ryood/ACS712_AmMeter/IMG_20200204_164413.jpg

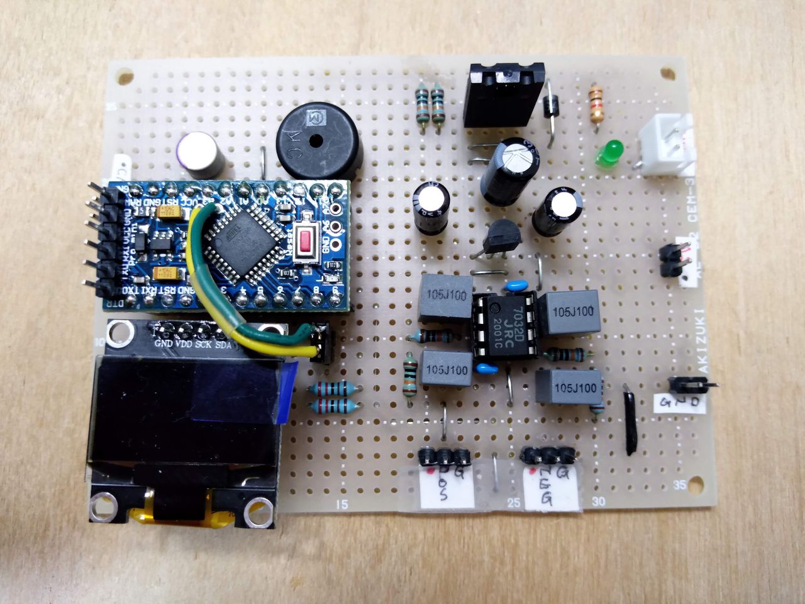
IMG_20200204_164413.jpg
