ryood/ACS712_AmMeter/IMG_20200204_164611.jpg

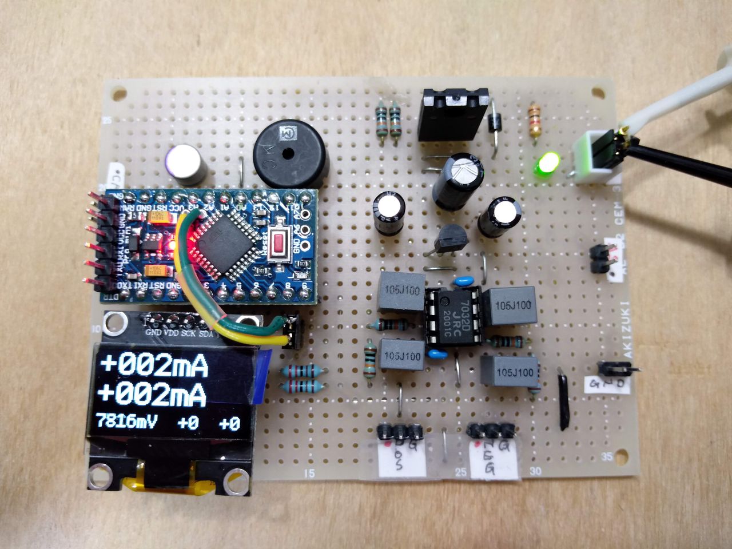
IMG_20200204_164611.jpg
