ryood/ACS712_AmMeter/ACS712-Dual.jpg

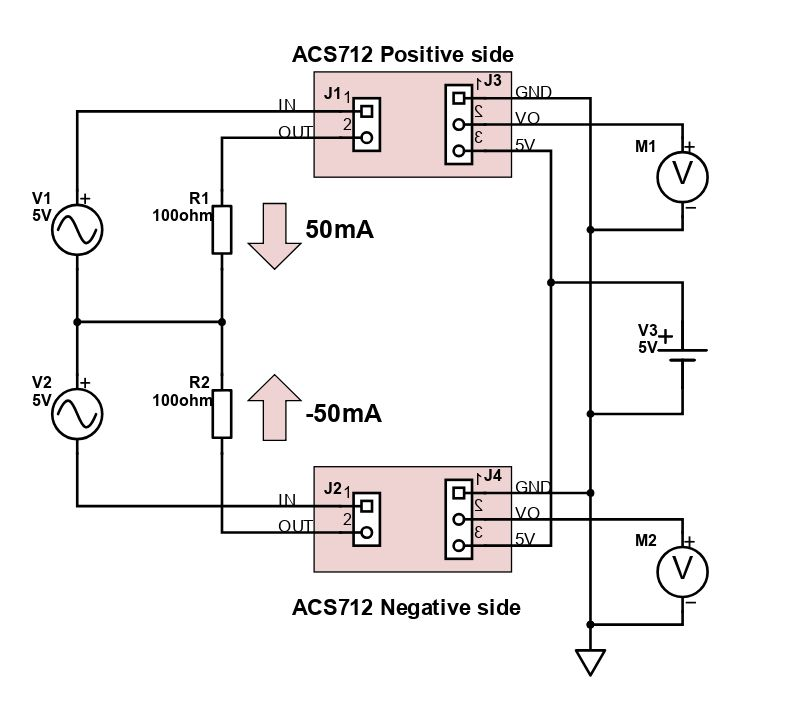
ACS712-Dual.jpg
