ryood/ACS712_AmMeter/ACS712_AmMeter_Diagram.png

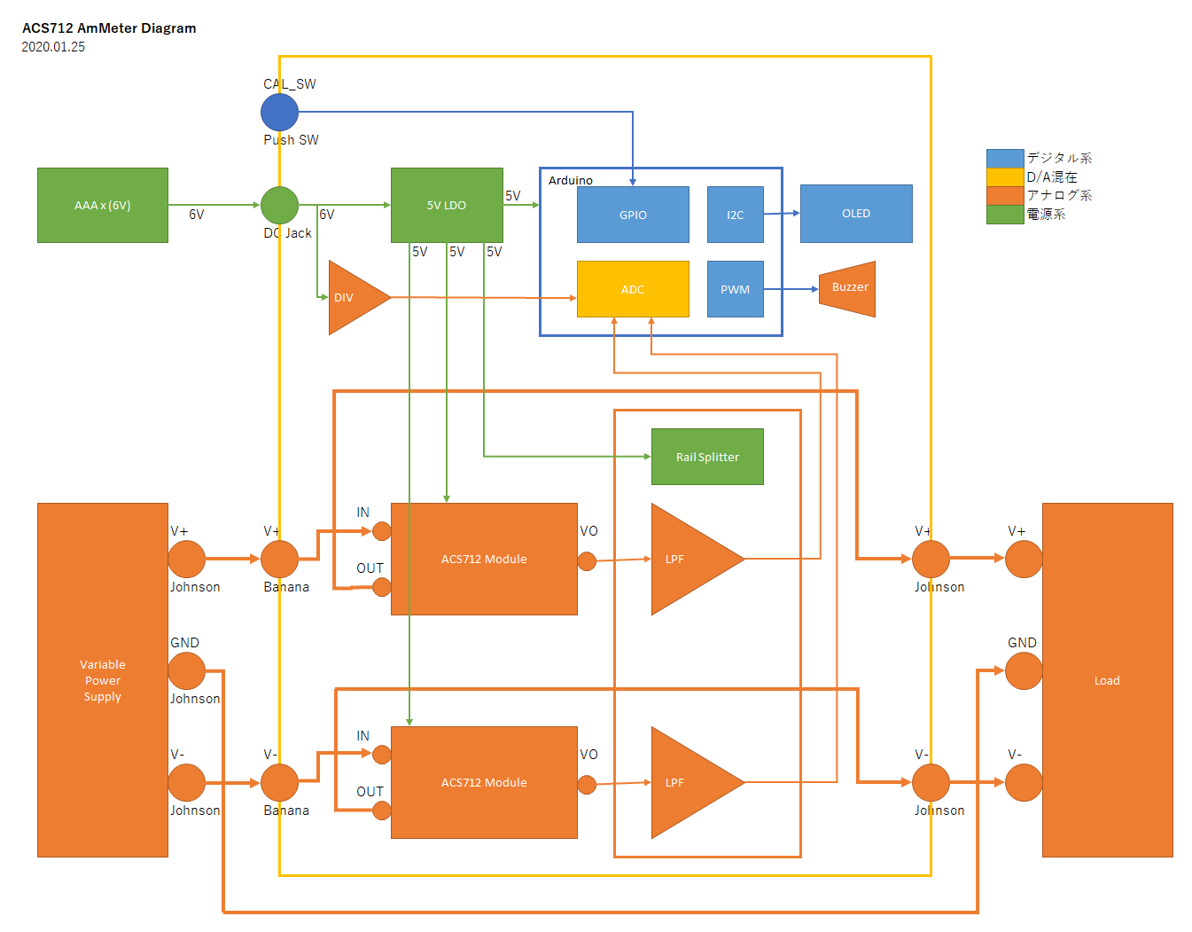
ACS712_AmMeter_Diagram.png
