ryood/ACS712_AmMeter/ACS712_AmMeter_Negative_Graph.png

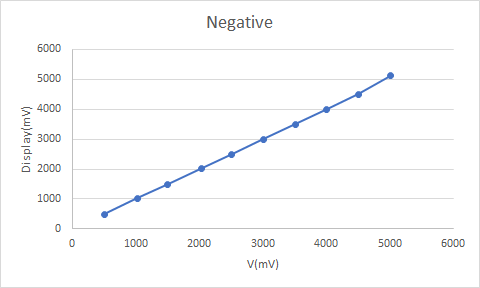
ACS712_AmMeter_Negative_Graph.png
