ryood/ACS712_AmMeter/etc/20200102_085544.png

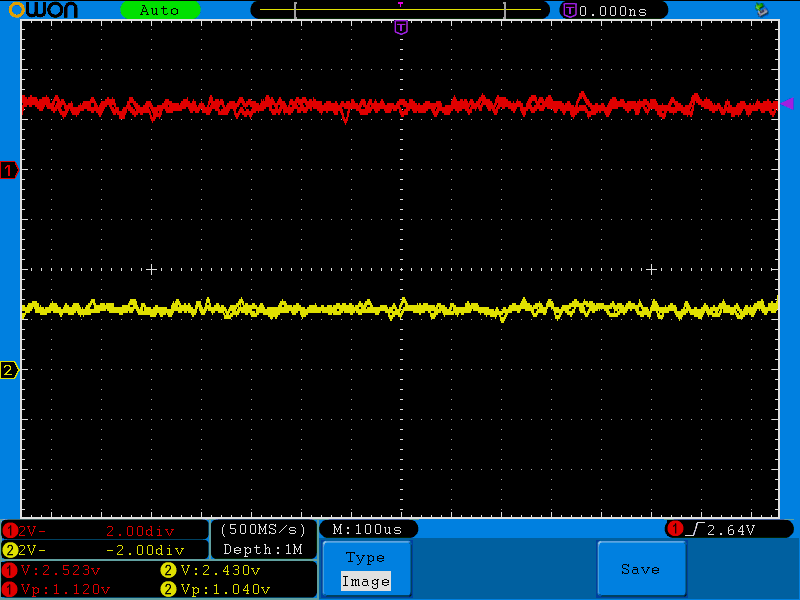
etc/20200102_085544.png
