ryood/ACS712_AmMeter/etc/20200102_085621.png

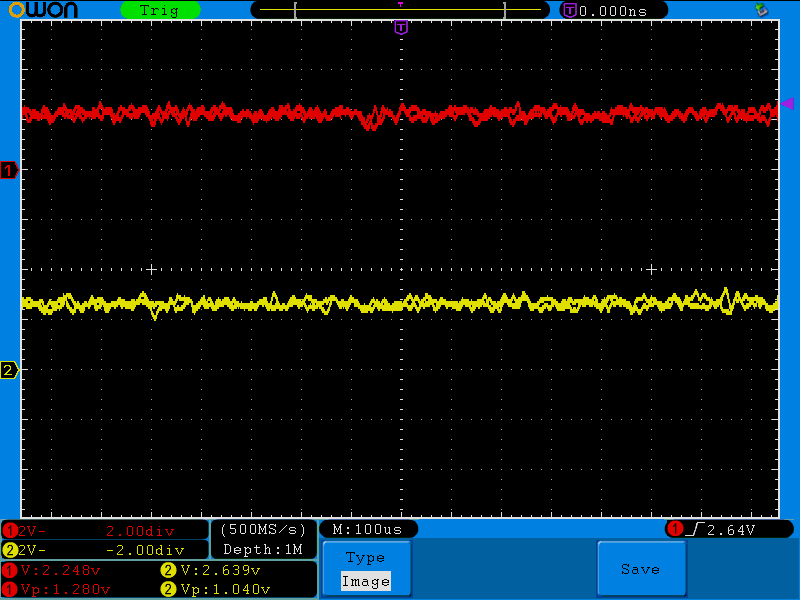
etc/20200102_085621.png
