ryood/ACS712_AmMeter/etc/20200102_085722.png

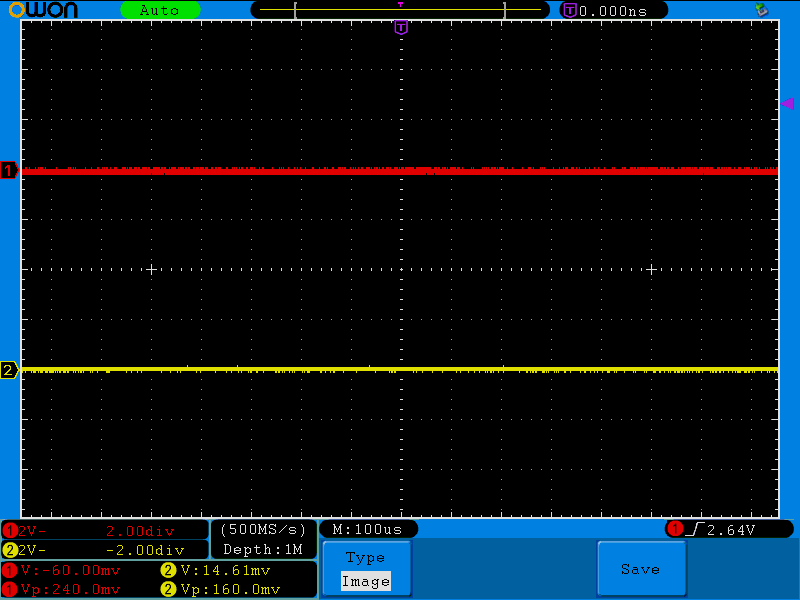
etc/20200102_085722.png
