ryood/ACS712_AmMeter/etc/IMG_20191228_145746.jpg

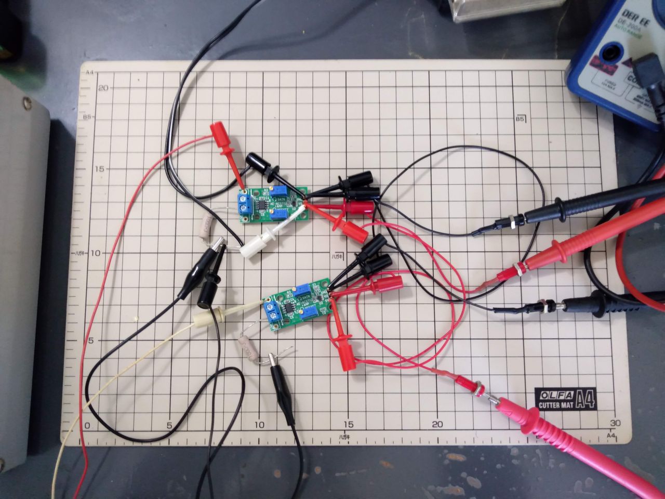
etc/IMG_20191228_145746.jpg
