ryood/ACS712_AmMeter/etc/IMG_20191228_152914.jpg

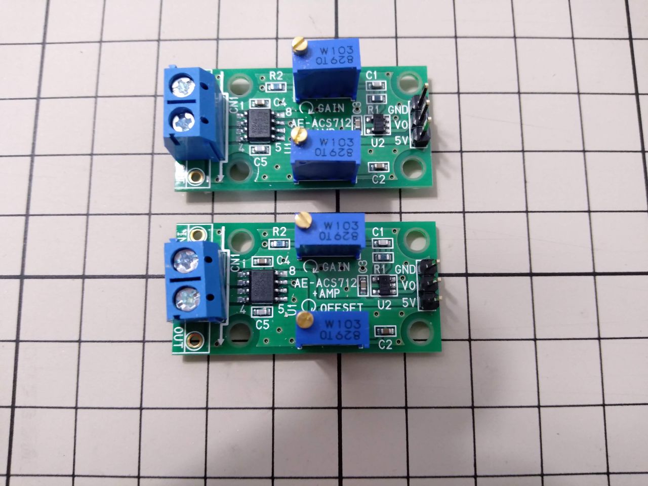
etc/IMG_20191228_152914.jpg
