ryood/ACS712_AmMeter/etc/IMG_20200102_083424.jpg

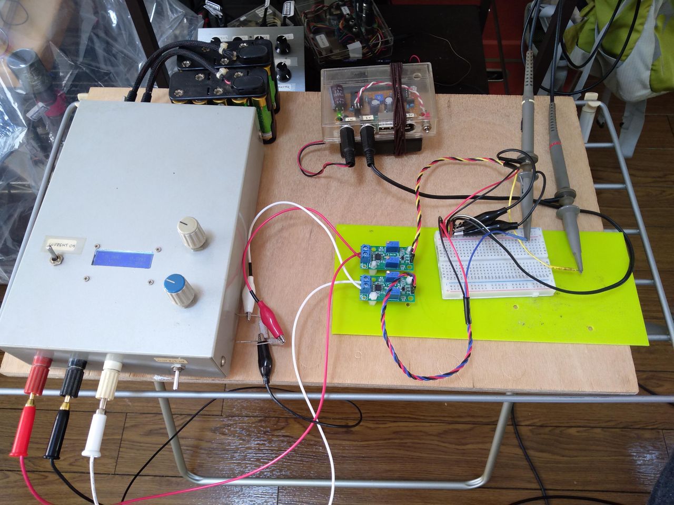
etc/IMG_20200102_083424.jpg
