ryood/ACS712_AmMeter/fritzing/ACS712_AmMeter_VCVS_LPF_ブレッドボード.png

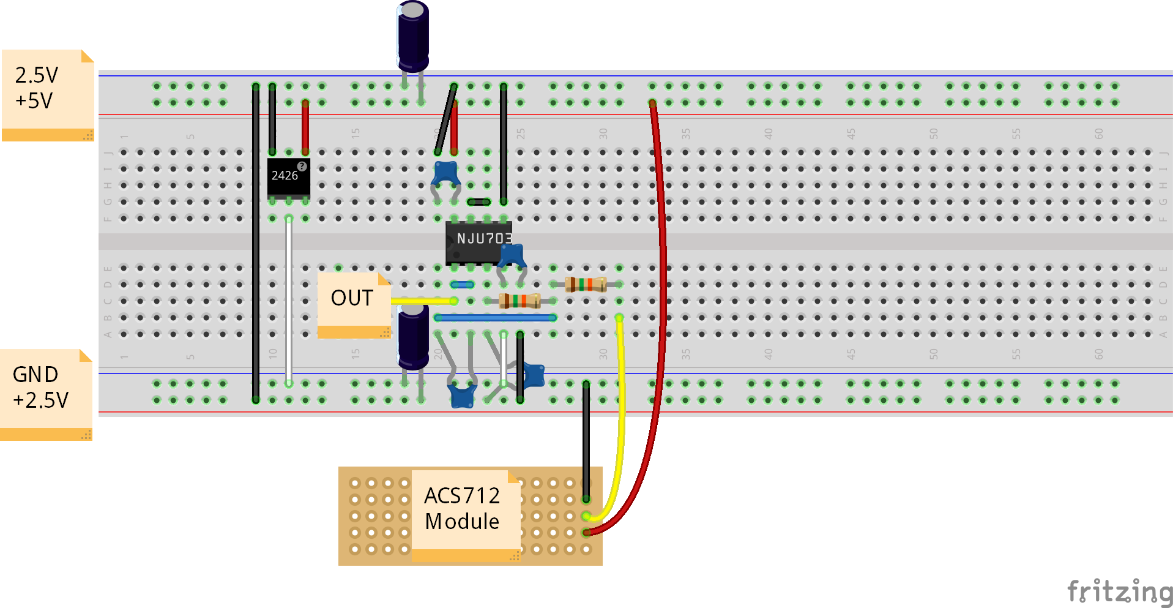
fritzing/ACS712_AmMeter_VCVS_LPF_ブレッドボード.png
