ryood/ACS712_AmMeter/IMG_20200204_164301.jpg

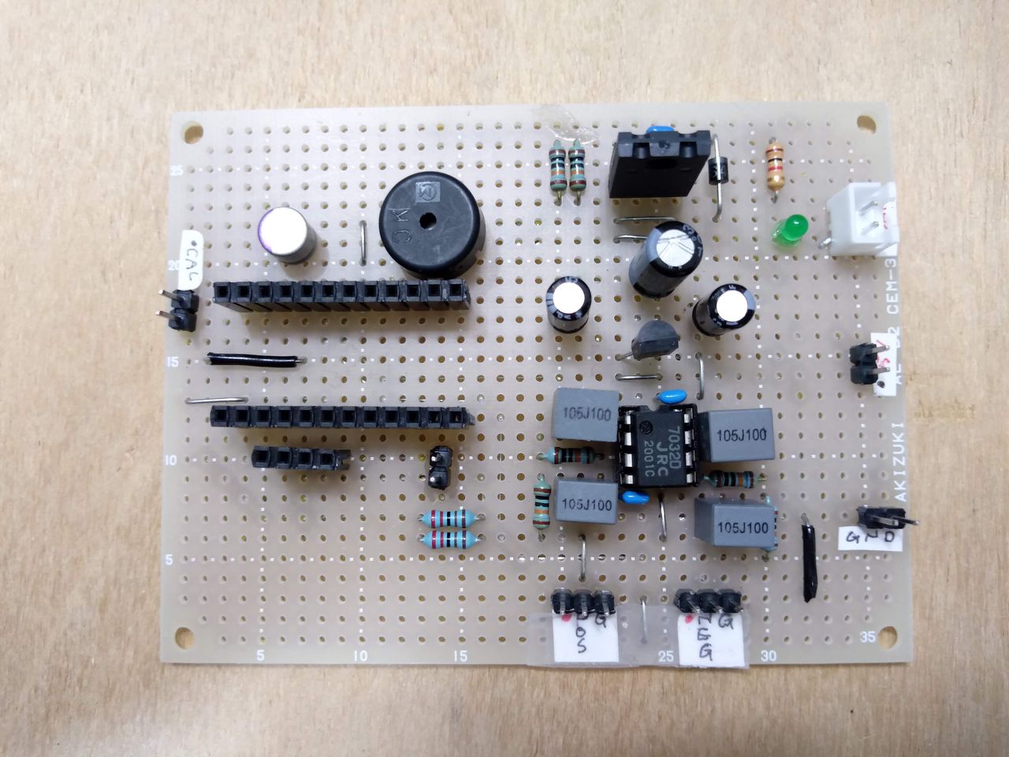
IMG_20200204_164301.jpg
