ryood/ACS712_AmMeter/IMG_20200204_164309.jpg

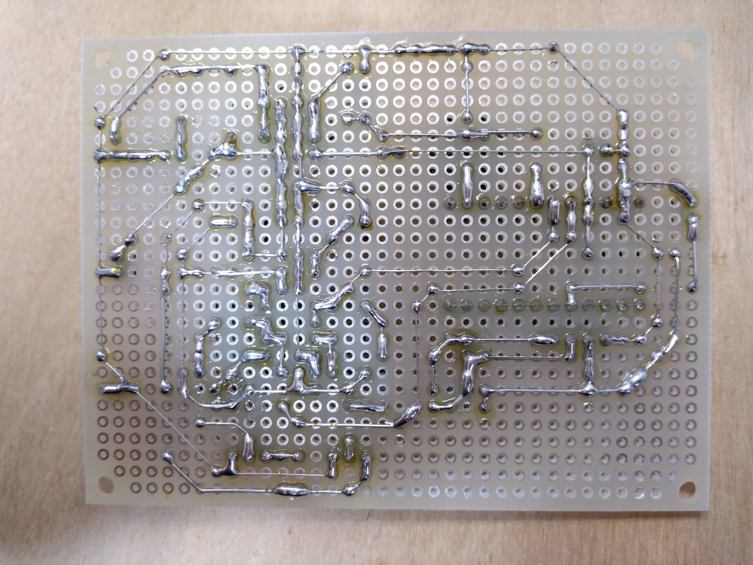
IMG_20200204_164309.jpg
