ryood/ACS712_AmMeter/IMG_20200210_165451.jpg

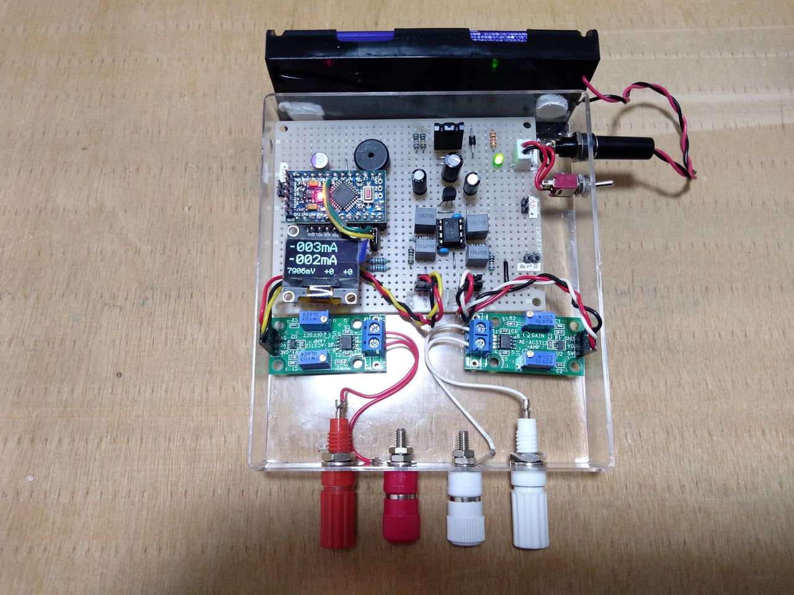
IMG_20200210_165451.jpg
