ryood/ACS712_AmMeter/kicad/ACS712_AmMeter.png

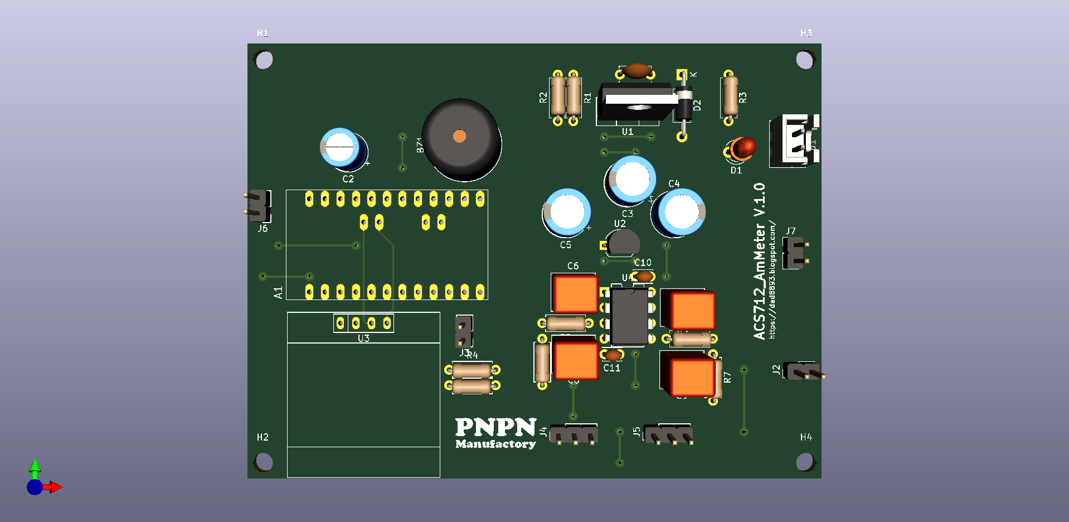
kicad/ACS712_AmMeter.png
