ryood/ACS712_AmMeter/kicad/ACS712_AmMeter_brd.PNG

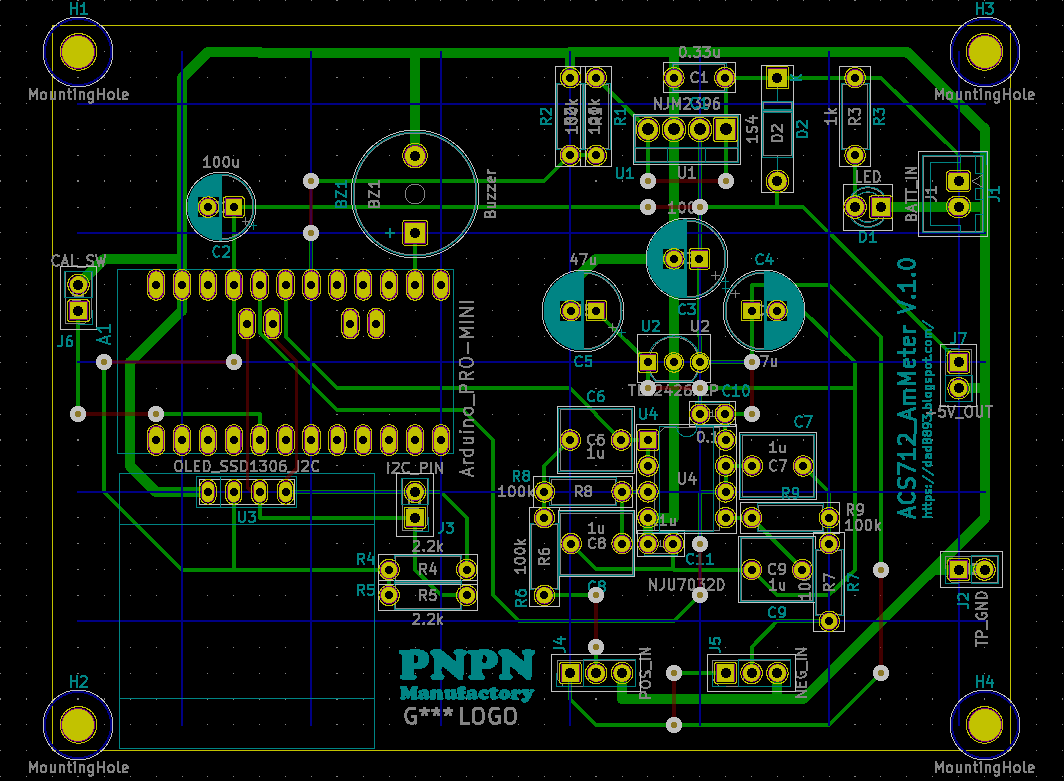
kicad/ACS712_AmMeter_brd.PNG
