ryood/ACS712_AmMeter/kicad/ACS712_AmMeter_sch.png

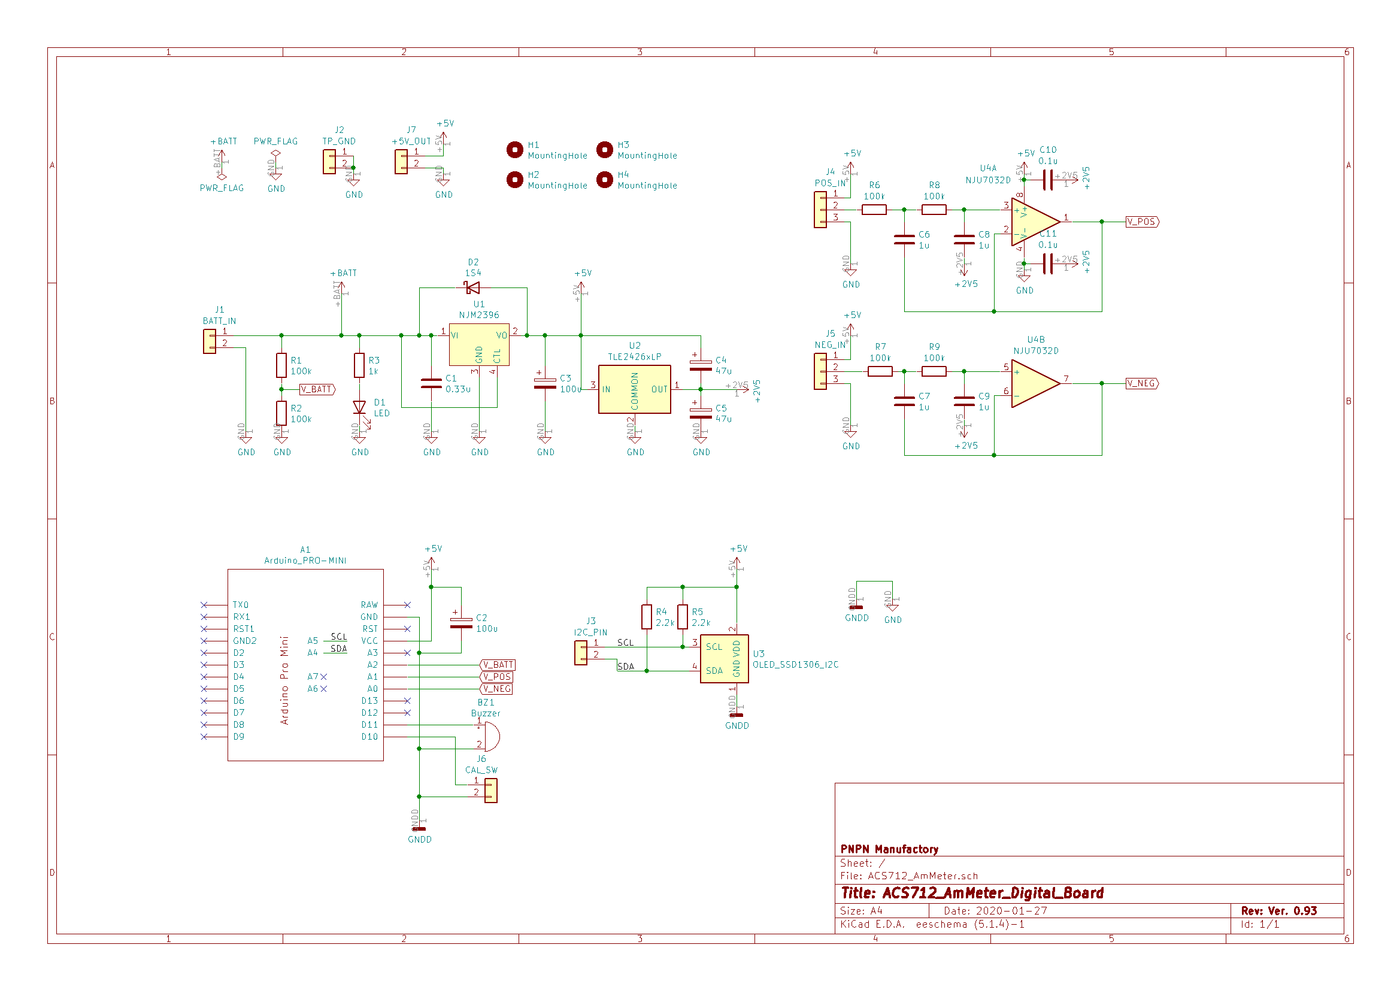
kicad/ACS712_AmMeter_sch.png
