ryood/ACS712_AmMeter/kicad/IMG_20200128_221436.jpg

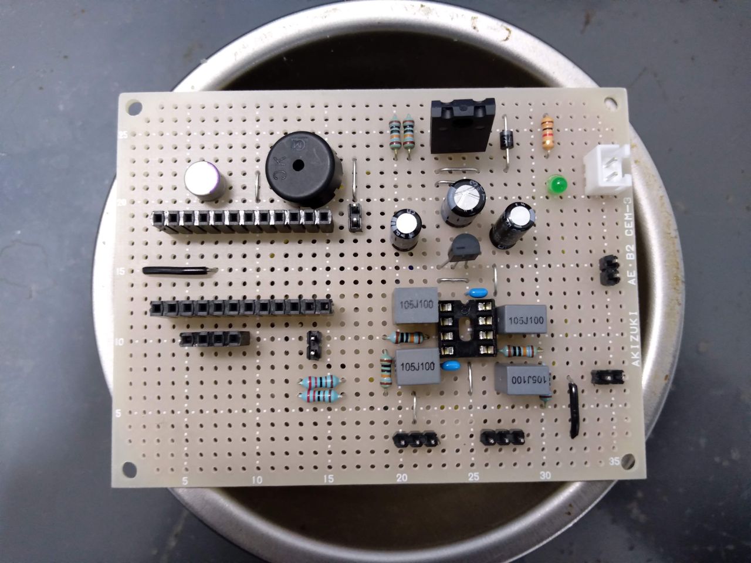
kicad/IMG_20200128_221436.jpg
