ryood/ACS712_AmMeter/kicad/logo/PNPN_Manufactory.dxf

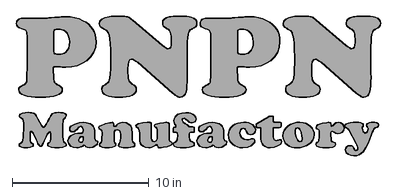
[picture p21: CAD file, 2020-01-18]
kicad/logo/PNPN_Manufactory.dxf
26.6 x 10.2 in
