ryood/ACS712_AmMeter/(list of files, cad)

Other CAD files:
CAD/ACS712_AmMeter_Case.dwg
CAD/秋月ポリカケース大.dwg
CAD/ACS712_TestBoard.dwg
kicad/logo/PNPN_Manufactory.dwg
