ryood/ACS712_AmMeter/spice/Noise_Filter_03.asc

C1: cap; 1u
C2: cap; 1u
R1: res; 100k
R2: res; 100k
U1: UniversalOpamp2
V1: voltage; PULSE(0 1 0 1f 1f 1); AC 1
V2: voltage; 2.5
V3: voltage; -2.5
Named nets: VCC, VEE, 0, OUT, IN
.ac oct 20 0.1 100k
;.tran 2
