ryood/ACS712_AmMeter/spice/Noise_Filter_02.asc

C1: cap; 0.47u
C2: cap; 0.47u
R1: res; 6.8k
R2: res; 6.8k
U1: UniversalOpamp2
V1: voltage; PULSE(-0.5 0.5 0 0 0 1m 2m); AC 1
V2: voltage; 2.5
V3: voltage; -2.5
Named nets: VCC, VEE, 0, OUT
.ac oct 20 1 1Meg
;.tran 200m
