ryood/ACS712_AmMeter/spice/Noise_Filter_01.asc

C1: cap; 1u
C2: cap; 1u
R1: res; 16k
R2: res; 16k
U1: UniversalOpamp2
V1: voltage; PULSE(0 1 0 0 0 1m 2m); AC 1
V2: voltage; 2.5
V3: voltage; -2.5
Named nets: VCC, VEE, 0, OUT
;ac oct 20 1 1Meg
;noise V(OUT) V1 oct 20 1 1Meg
.tran 200m
