ryood/ACS712_AmMeter/(list of files, drawings)

Other design files:
fritzing/ACS712_AmMeter_Test1.fzz
fritzing/ACS712_AmMeter_Test2.fzz
fritzing/ACS712_AmMeter_Test3.fzz
fritzing/ACS712_AmMeter_VCVS_LPF.fzz
fritzing/ACS712_AmMeter_VCVS_LPFx2.fzz
