ryood/ACS712_AmMeter/kicad/ACS712_AmMeter/ACS712_AmMeter/ACS712_AmMeter.kicad_pcb

## KiCad design kicad/ACS712_AmMeter/ACS712_AmMeter/ACS712_AmMeter.kicad_pcb (2020-02-06)

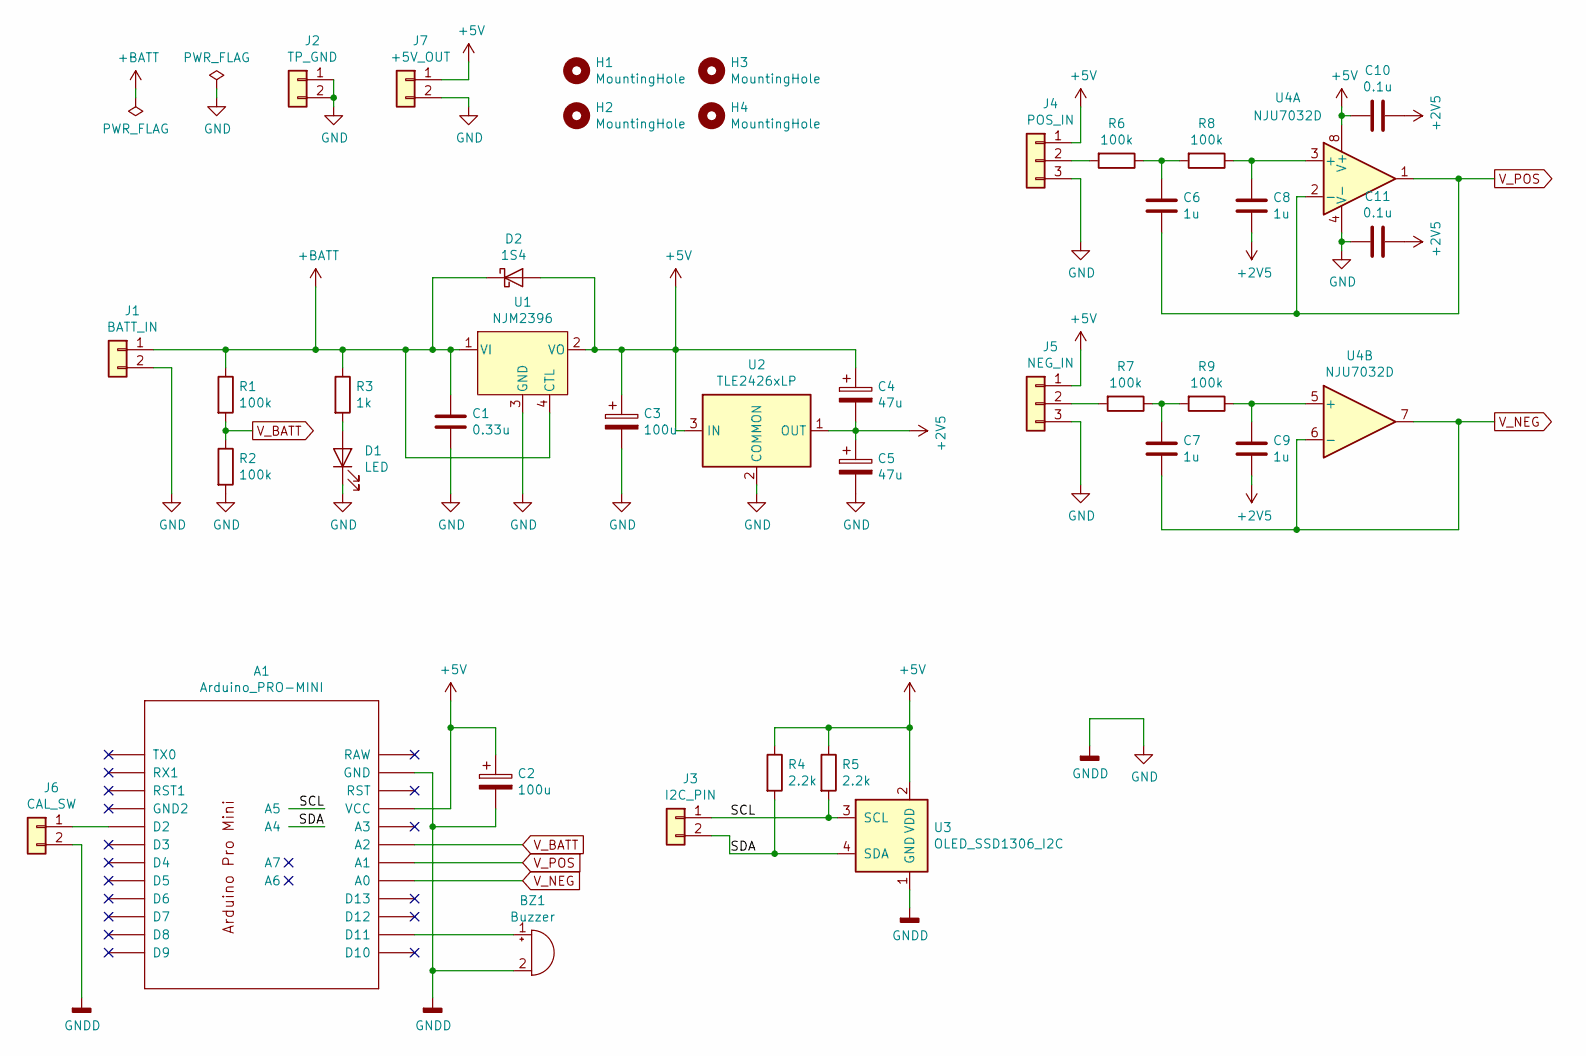
[picture p22: schematic ACS712_AmMeter.sch, ACS712_AmMeter_Digital_Board]

Parts:
A1: Arduino_PRO-MINI; Arduino-PRO-MINI-2-simple
BZ1: Buzzer; Buzzer_12x9.5RM7.6
C1: 0.33u; C_Disc_D5.0mm_W2.5mm_P5.00mm
C2: 100u; CP_Radial_D6.3mm_P2.50mm
C3: 100u; CP_Radial_D7.5mm_P2.50mm
C4, C5: 47u; CP_Radial_D7.5mm_P2.50mm
C6, C7, C8, C9: 1u; C_Rect_L7.0mm_W6.0mm_P5.00mm
C10, C11: 0.1u; C_Disc_D3.0mm_W2.0mm_P2.50mm
D1: LED; LED_D3.0mm
D2: 1S4; D_A-405_P10.16mm_Horizontal
H1, H2, H3, H4: MountingHole; MountingHole_3.2mm_M3
J1: BATT_IN; JST_XH_B2B-XH-A_1x02_P2.50mm_Vertical
J2: TP_GND; PinHeader_1x02_P2.54mm_Vertical
J3: I2C_PIN; PinHeader_1x02_P2.54mm_Vertical
J4: POS_IN; PinHeader_1x03_P2.54mm_Vertical
J5: NEG_IN; PinHeader_1x03_P2.54mm_Vertical
J6: CAL_SW; PinHeader_1x02_P2.54mm_Vertical
J7: +5V_OUT; PinHeader_1x02_P2.54mm_Vertical
R1, R2, R6, R7, R8, R9: 100k; R_Axial_DIN0207_L6.3mm_D2.5mm_P7.62mm_Horizontal
R3: 1k; R_Axial_DIN0207_L6.3mm_D2.5mm_P7.62mm_Horizontal
R4, R5: 2.2k; R_Axial_DIN0207_L6.3mm_D2.5mm_P7.62mm_Horizontal
U1: NJM2396; NJM2396_Vertical
U2: TLE2426xLP; TO-92_Inline_Wide
U3: OLED_SSD1306_I2C
U4: NJU7032D; DIP-8_W7.62mm

Connections:
+2V5: C4.2, C5.1, C8.2, C9.2, C10.1, C11.1, U2.1 (OUT)
+5V: A1.VCC, C2.1, C3.1, C4.1, C10.2, D2.2 (A), J4.1, J5.1, J7.1, R4.1, R5.1, U1.2 (VO), U2.3 (IN), U3.2 (VDD), U4.8 (V+)
+BATT: C1.1, D2.1 (K), J1.1, R1.1, R3.1, U1.1 (VI), U1.4 (CTL)
/SCL: A1.A5, J3.1, R5.2, U3.3 (SCL)
/SDA: A1.A4, J3.2, R4.2, U3.4 (SDA)
GND: A1.GND, BZ1.2 (+), C1.2, C2.2, C3.2, C5.2, C11.2, D1.1 (K), J1.2, J2.1, J2.2, J4.3, J5.3, J6.2, J7.2, R2.2, U1.3 (GND), U2.2 (COMMON), U3.1 (GND), U4.4 (V-)
unnamed: A1.D2, J6.1
unnamed: A1.D11, BZ1.1 (-)
unnamed: C6.1, R6.1, R8.2
unnamed: C7.1, R7.1, R9.2
unnamed: C8.1, R8.1, U4.3 (+)
unnamed: C9.1, R9.1, U4.5 (+)
unnamed: D1.2 (A), R3.2
unnamed: J4.2, R6.2
unnamed: J5.2, R7.2
V_BATT: A1.A2, R1.2, R2.1
V_NEG: A1.A0, C7.2, U4.6 (-), U4.7
V_POS: A1.A1, C6.2, U4.1, U4.2 (-)

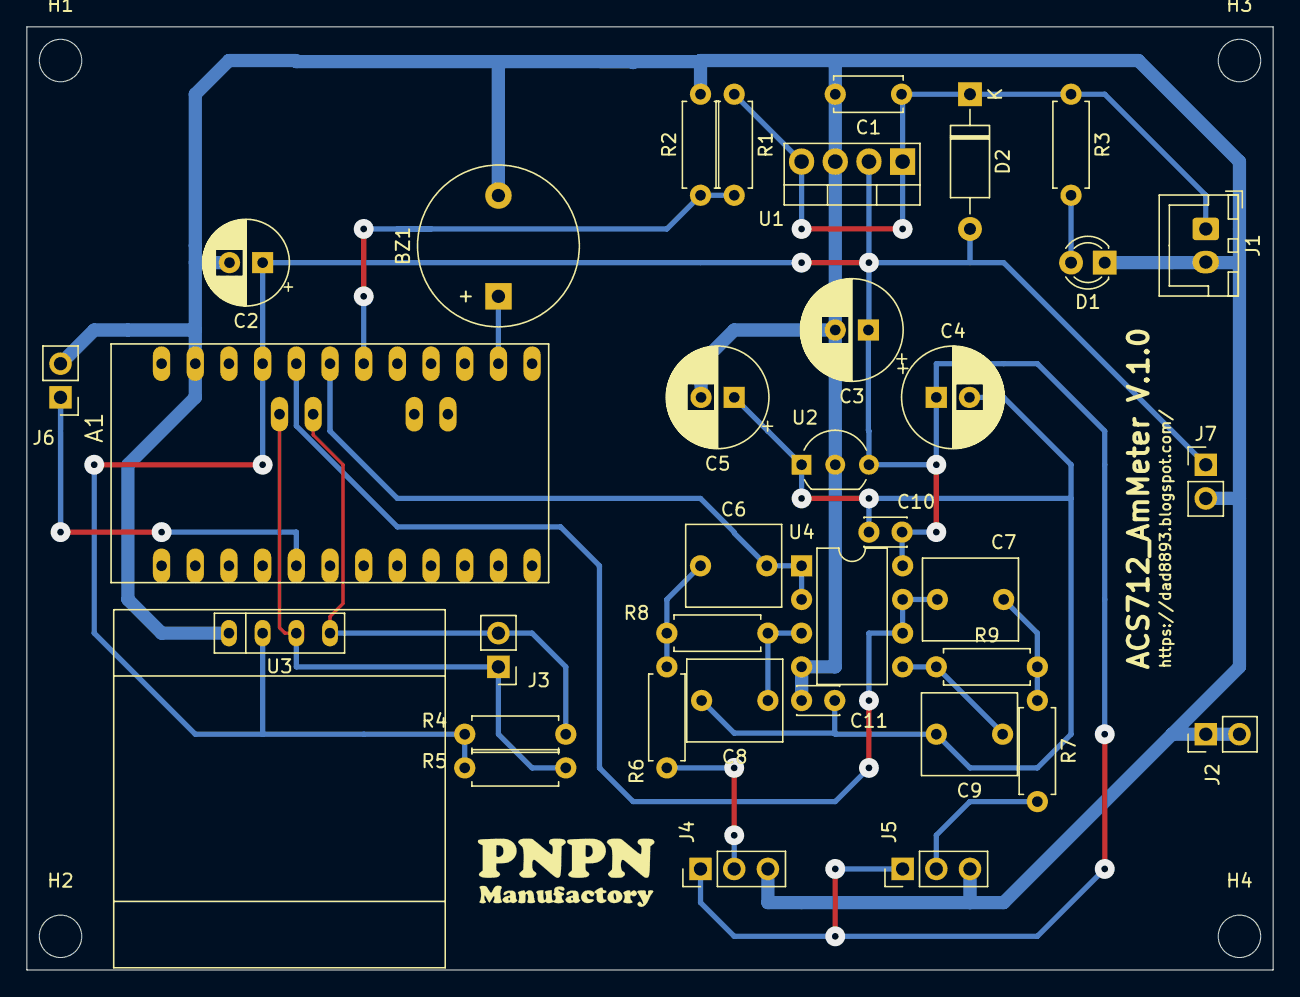
[picture p23: board ACS712_AmMeter.kicad_pcb from above]

Board: 2 copper layers, 94.0 x 71.1 mm, 39 parts (0 on the bottom side), 18 nets.
