ryood/ACS712_AmMeter/kicad/ACS712_AmMeter/ACS712_AmMeter_Analog/ACS712_AmMeter_Analog.kicad_pcb

## KiCad design kicad/ACS712_AmMeter/ACS712_AmMeter_Analog/ACS712_AmMeter_Analog.kicad_pcb (2020-01-18)

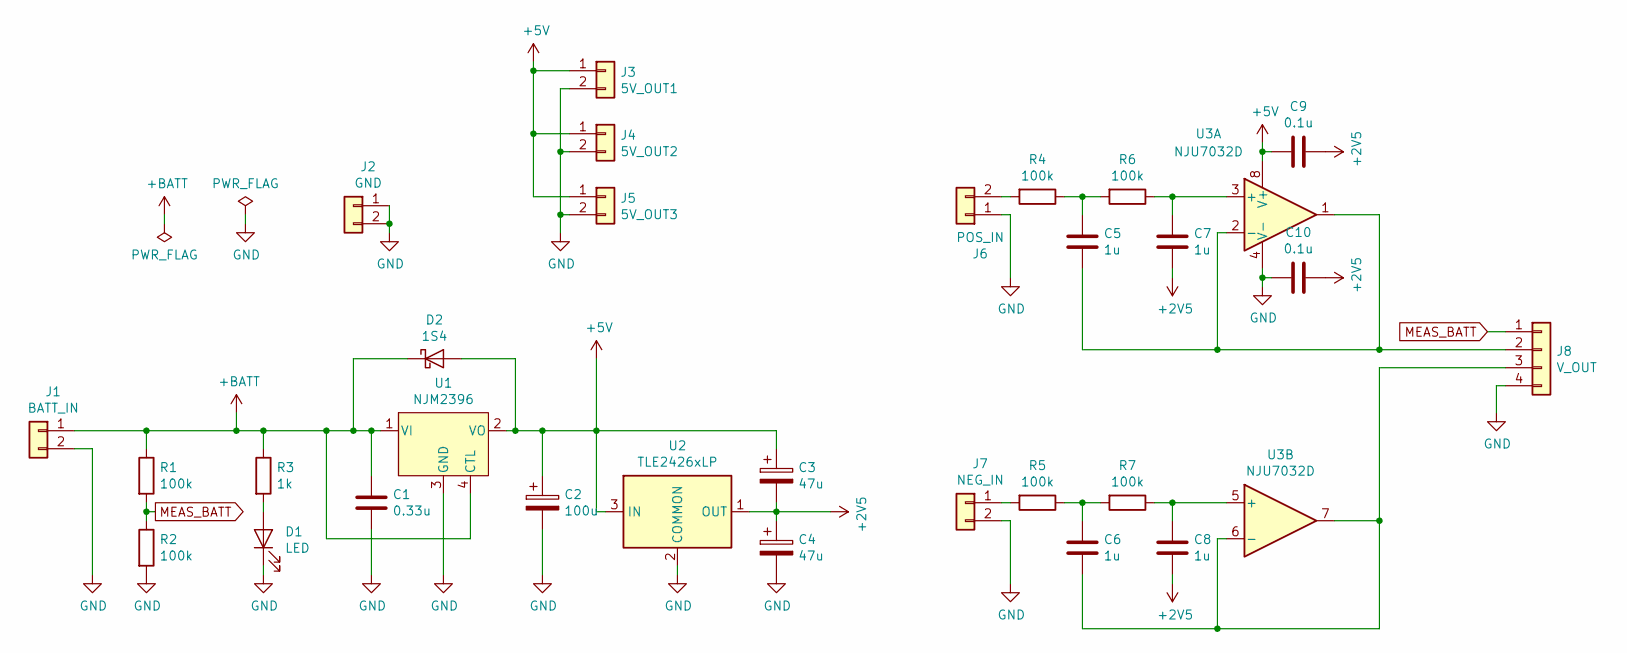
[picture p24: schematic ACS712_AmMeter_Analog.sch]

Parts:
C1: 0.33u; C_Disc_D5.0mm_W2.5mm_P5.00mm
C2: 100u; CP_Radial_D7.5mm_P2.50mm
C3, C4: 47u; CP_Radial_D7.5mm_P2.50mm
C5, C6, C7, C8: 1u; C_Rect_L7.0mm_W6.0mm_P5.00mm
C9, C10: 0.1u; C_Disc_D3.0mm_W2.0mm_P2.50mm
D1: LED; LED_D3.0mm
D2: 1S4; D_A-405_P10.16mm_Horizontal
J1: BATT_IN; PinHeader_1x02_P2.54mm_Horizontal
J2: GND; PinHeader_1x02_P2.54mm_Vertical
J3: 5V_OUT1; PinHeader_1x02_P2.54mm_Horizontal
J4: 5V_OUT2; PinHeader_1x02_P2.54mm_Horizontal
J5: 5V_OUT3; PinHeader_1x02_P2.54mm_Horizontal
J6: POS_IN; PinHeader_1x02_P2.54mm_Horizontal
J7: NEG_IN; PinHeader_1x02_P2.54mm_Horizontal
J8: V_OUT; PinHeader_1x04_P2.54mm_Horizontal
R1, R2, R4, R5, R6, R7: 100k; R_Axial_DIN0207_L6.3mm_D2.5mm_P7.62mm_Horizontal
R3: 1k; R_Axial_DIN0207_L6.3mm_D2.5mm_P7.62mm_Horizontal
U1: NJM2396; TO-220-4_Horizontal_TabDown
U2: TLE2426xLP; TO-92_Inline_Wide
U3: NJU7032D; DIP-8_W7.62mm

Connections:
+2V5: C3.2, C4.1, C7.2, C8.2, C9.1, C10.1, U2.1 (OUT)
+5V: C2.1, C3.1, C9.2, D2.2 (A), J3.1, J4.1, J5.1, U1.2 (VO), U2.3 (IN), U3.8 (V+)
+BATT: C1.1, D2.1 (K), J1.1, R1.1, R3.1, U1.1 (VI), U1.4 (CTL)
GND: C1.2, C2.2, C4.2, C10.2, D1.1 (K), J1.2, J2.1, J2.2, J3.2, J4.2, J5.2, J6.1, J7.2, J8.4, R2.2, U1.3 (GND), U2.2 (COMMON), U3.4 (V-)
MEAS_BATT: J8.1, R1.2, R2.1
unnamed: C5.1, R4.1, R6.2
unnamed: C5.2, J8.2, U3.1, U3.2 (-)
unnamed: C6.1, R5.1, R7.2
unnamed: C6.2, J8.3, U3.6 (-), U3.7
unnamed: C7.1, R6.1, U3.3 (+)
unnamed: C8.1, R7.1, U3.5 (+)
unnamed: D1.2 (A), R3.2
unnamed: J6.2, R4.2
unnamed: J7.1, R5.2

Board: 2 copper layers, 30 parts (0 on the bottom side), 14 nets, no tracks yet.
