ryood/ACS712_AmMeter/(commit log)

2020-01-03 Update: VCVS LPF
    [ACS712_AmMeter_VCVS_LPFx2.fzz]
2020-01-09 Add: Arduino Sketch
    [ACS712_AmMeter_Block_Diagram.xlsx]
2020-01-18 Add: KiCad design
    [ACS712_AmMeter.kicad_pcb, ACS712_AmMeter.sch, ACS712_AmMeter_Analog.kicad_pcb, ACS712_AmMeter_Analog.sch, PNPN_Manufactory.dwg, PNPN_Manufactory.dxf]
2020-01-20 Update: integrate digital and analog
    [ACS712_AmMeter.kicad_pcb, ACS712_AmMeter.sch, ACS712_AmMeter_Block_Diagram.xlsx]
2020-01-20 Update: Arduino sketch
2020-01-22 Add: logo bule, Update: KiCad design
    [ACS712_AmMeter.kicad_pcb]
2020-01-25 Update: Board design
    [ACS712_AmMeter.kicad_pcb, ACS712_AmMeter.sch]
2020-01-29 Ubdate: Board design
    [ACS712_AmMeter.kicad_pcb, ACS712_AmMeter.sch, ACS712_AmMeter_Block_Diagram.xlsx]
2020-02-06 Soldering completed
    [ACS712 AmMeter Voltage.xlsx, ACS712_AmMeter.kicad_pcb, ACS712_AmMeter.sch, ACS712_AmMeter_Case.dwg, ACS712_AmMeter_テスト表.xlsx]
2020-03-01 Bugfix: Arduino sketch
    [ACS712_AmMeter性能測定.xlsx]
